sagolmintang/OneGrip-Play/README.md

# OneGrip-Play
한 손과 제한된 손가락 움직임만으로 PC와 Nintendo Switch를 조작할 수 있도록 제작한 보조 입력장치
