sagolmintang/OneGrip-Play/STL/조이스틱/ONEGRIP_JOYSTICK_STRAP.3mf

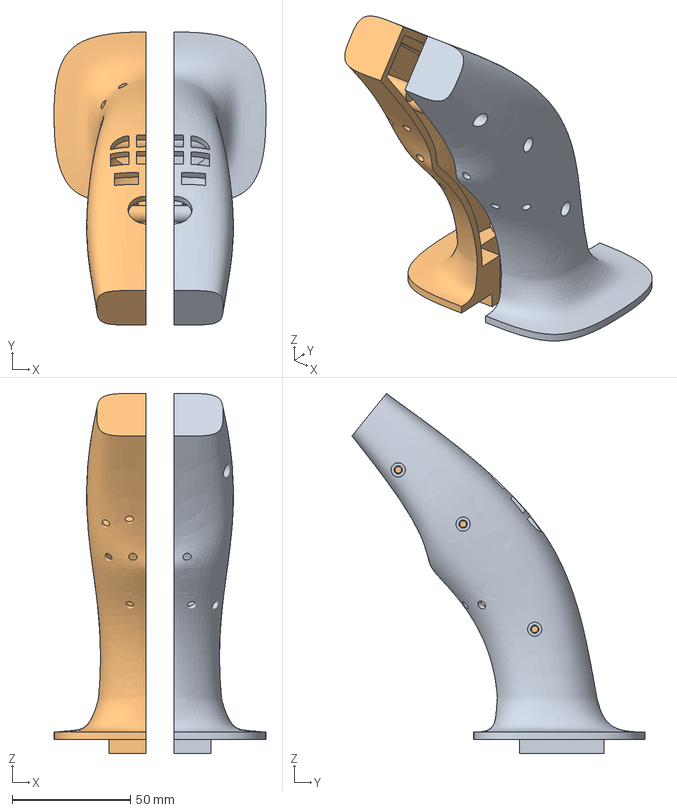
[picture p17: CAD file, 2026-10-04]
STL/조이스틱/ONEGRIP_JOYSTICK_STRAP.3mf
89.5 x 123.9 x 152.1 mm
ONEGRIP_REFERENCE_LINE_N1_N2_INSIDE_OUT_STRAP_JaD
ONEGRIP_REFERENCE_LINE_N1_N2_INSIDE_OUT_STRAP_JfD
