sagolmintang/OneGrip-Play/STL/카세트/ONEGRIP_UPPER_PLATE_MATCHED_SHALLOW_M3_BACKING_FINAL.stl

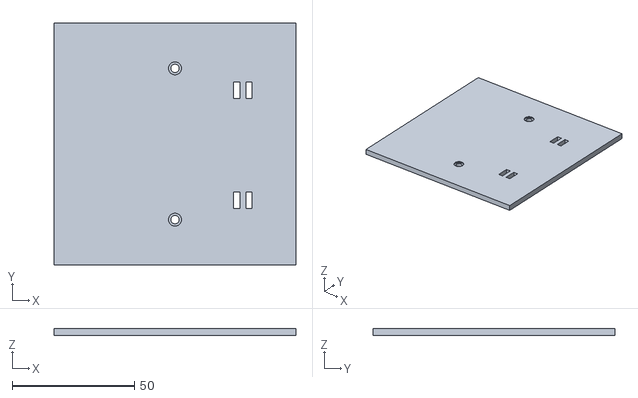
[picture p18: CAD file, 2026-10-04]
STL/카세트/ONEGRIP_UPPER_PLATE_MATCHED_SHALLOW_M3_BACKING_FINAL.stl
98.8 x 98.8 x 3.00
