sagolmintang/OneGrip-Play/STL/조이스틱/ONEGRIP_JOYSTICK_BUTTON_SET.stl

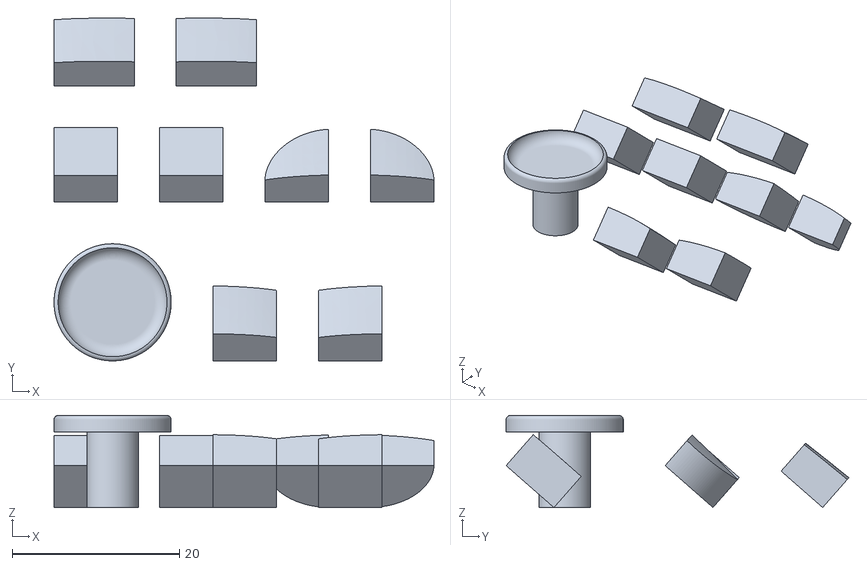
[picture p19: CAD file, 2026-10-04]
STL/조이스틱/ONEGRIP_JOYSTICK_BUTTON_SET.stl
45.4 x 41.0 x 11.0
