sagolmintang/OneGrip-Play/STL/카세트/ONEGRIP_STOCK_SPRING_BASE_CASSETTE_LID_PRINT_LAYOUT_V5_REMOVE_4_STANDOFFS.stl

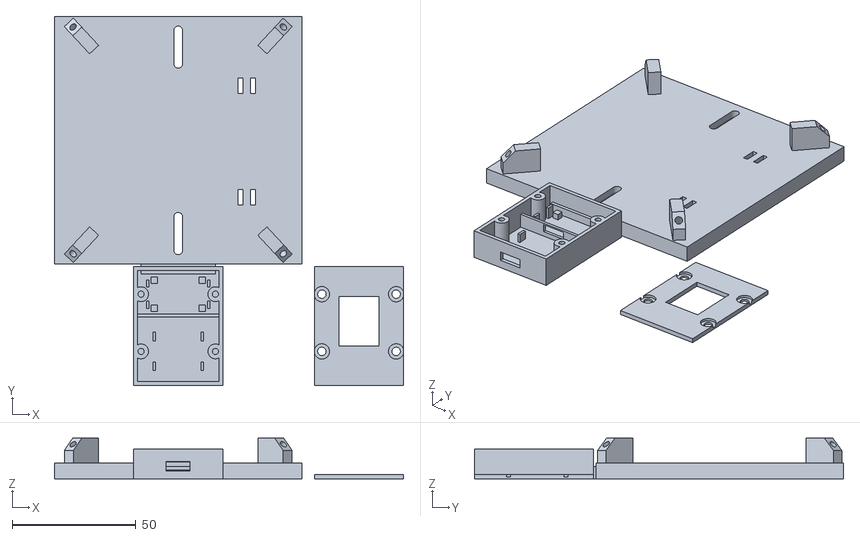
[picture p20: CAD file, 2026-10-04]
STL/카세트/ONEGRIP_STOCK_SPRING_BASE_CASSETTE_LID_PRINT_LAYOUT_V5_REMOVE_4_STANDOFFS.stl
141.0 x 149.0 x 16.5
