sagolmintang/OneGrip-Play/STL/조이스틱/Joystick_Small_joystick_attachment_SOLID_TOP_V1.stl

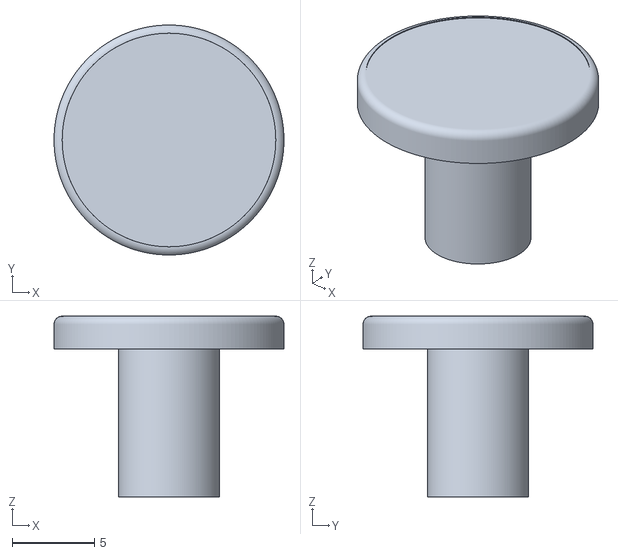
[picture p21: CAD file, 2026-10-04]
STL/조이스틱/Joystick_Small_joystick_attachment_SOLID_TOP_V1.stl
14.0 x 14.0 x 11.0
