sagolmintang/OneGrip-Play/STL/카세트/ONEGRIP_CASSETTE.stl

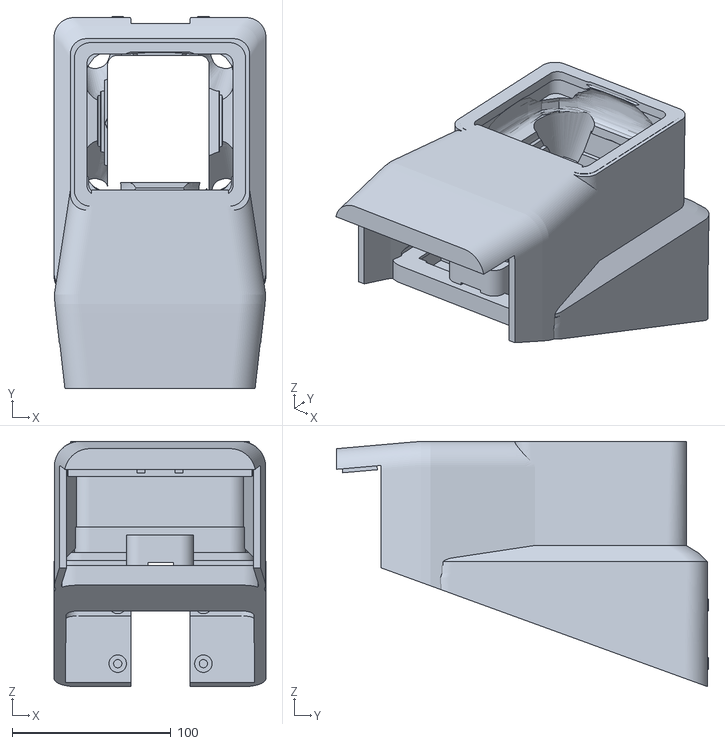
[picture p22: CAD file, 2026-10-04]
STL/카세트/ONEGRIP_CASSETTE.stl
133.6 x 234.5 x 154.6
