sagolmintang/OneGrip-Play/STL/카세트/ONEGRIP_ARMREST.stl

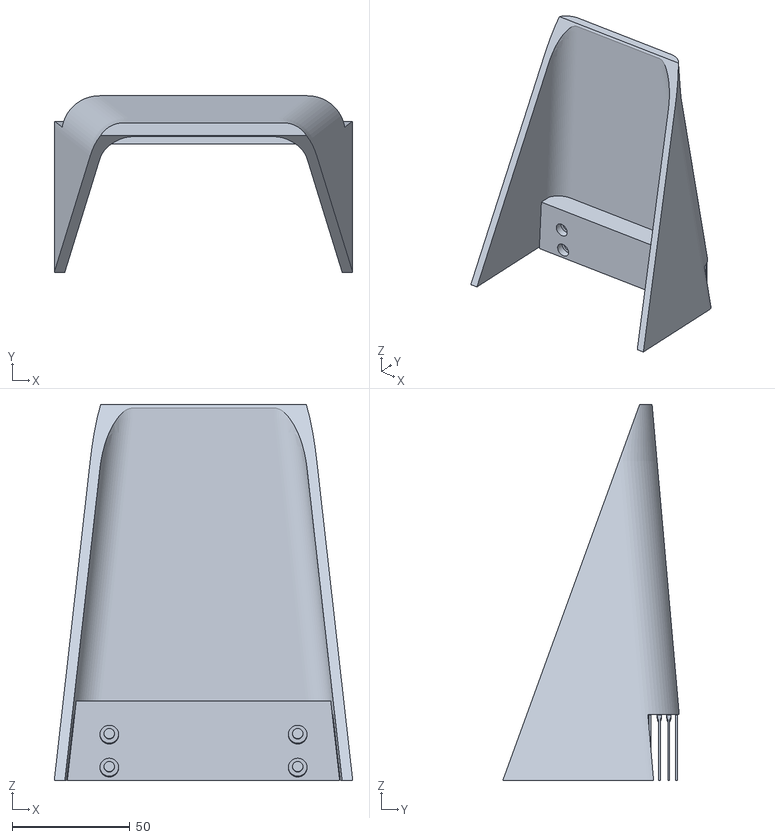
[picture p23: CAD file, 2026-10-04]
STL/카세트/ONEGRIP_ARMREST.stl
126.7 x 74.9 x 159.7
