sagolmintang/OneGrip-Play/STL/카세트/C09_CONTINUOUS_CURVED_CARRIER_THUMB_CORE_MODIFIED_V2_NARROW_PLATE.stl

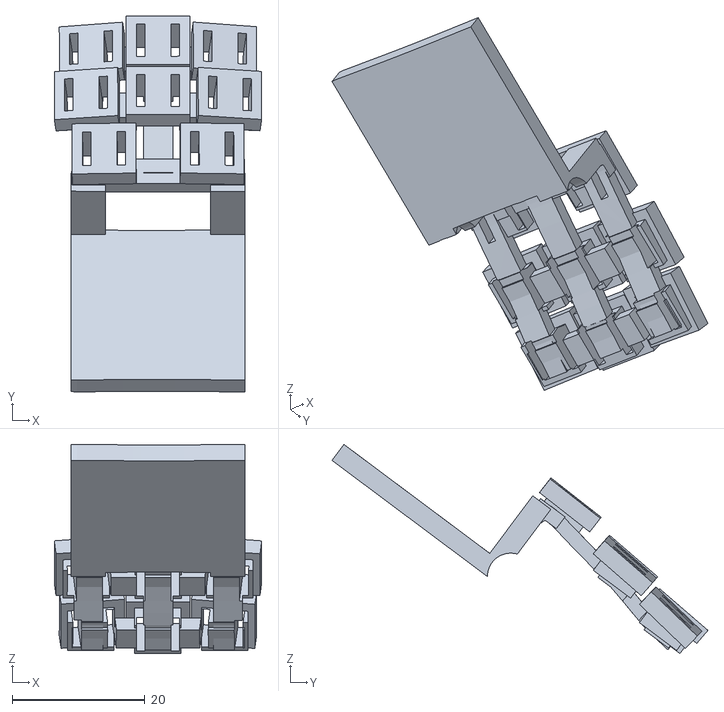
[picture p24: CAD file, 2026-10-04]
STL/카세트/C09_CONTINUOUS_CURVED_CARRIER_THUMB_CORE_MODIFIED_V2_NARROW_PLATE.stl
31.2 x 56.6 x 31.5
